gschmidt958/pdp11-05-reawakening/docs/PDP-11-05_Panel_Reawakening-Quick_Reference_Full_Page.pdf

# PDP-11/05 Panel Reawakening

## Quick Reference

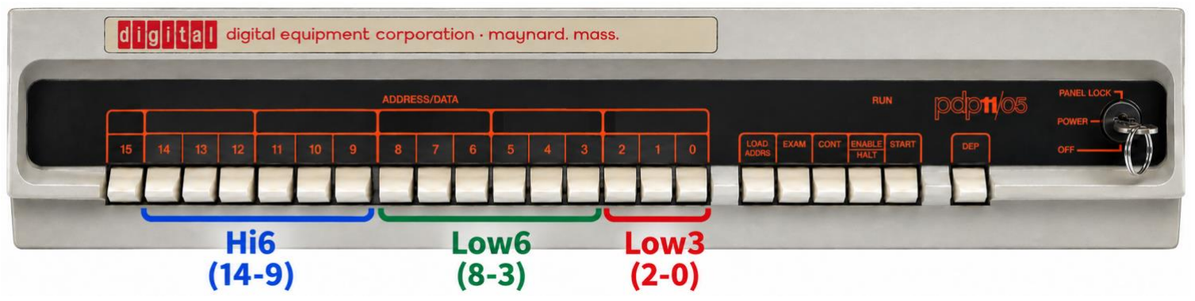
[picture p2: figure]

Toggle START to enter the mode set on Low3.

## Modes

Code | Mode | Hi6 | Low6 | Notes
0 (000) | Switch Echo | — | — | Echoes address/data switches directly on the LED display.
1 (001) | Binary Clock | — | — | CONTINUE cycles time → temperature → timer. Westminster chime on the quarter hour.
2 (010) | Blinkenlights Computer | Effect Selection | Track Selection | Audio and LED display effects run independently.
3 (011) | Soundboard | — | Theme Selection | Themed clips with voice-reactive VU meter (themes below).
4 (100) | Knight Rider | — | — | Fixed track with scanning-light display effect.
5 (101) | Jukebox | Track Selection | Folder Selection | SD card music player with music-style VU meter.
6 (110) | Bluetooth Audio | — | — | BT201 switches to Bluetooth source; volume from phone.
7 (111) | Flash Settings | — | — | CONTINUE cycles Address Select → Reset → VU Calibration.

## Soundboard Themes

Low6 | Theme
0 Random theme cycling (without replacement)
1 Robby the Robot (Forbidden Planet)
2 The B9 Environmental Robot (Lost in Space)
3 The HAL 9000 Computer (2001: A Space Odyssey) 4 Star Trek (original series)
5 Star Wars
6 Colossus (The Forbin Project)
7+ | Random track from random theme

LOAD ADDRS · EXAM · CONT · ENABLE/HALT · START · DEP — see the User Manual for full per-mode control behavior.

# PDP-11/05 Panel Reawakening

## Jukebox Channels

Mode 5 (101) · Low6 selects channel

Ch# | Channel Name | Ch# | Channel Name
1 | Electronic Ambient Covers | 15 | Computer World (Full Album)
2 | Ambient Electronic I | 16 | The Colours of Infinity
3 | Ambient Electronic II | 17 | Pink Floyd Style Ambient Music
4 | Synthwave | 18 | Voyage 34 (Full Album)
5 | Artemis Station | 19 | As Falls Wichita, So Falls Wichita Falls (Full Album)
6 | Cadwell’s Reach | 20 | I Dream of Star Trek
7 | Echelon Protocol | 21 | Forbidden Planet Electronic Tonalities
8 | Navigating a Latent Space | 22 | Do it Yourself
9 | Arrival at Myriah’s Shadow | 23 | Initial Call to the Military Fire Station from Chernobyl
10 | Night City | 24 | Jupiter II Engines
11 | Nova Sonus | 25 | Theme from “The Twilight Zone”
12 | To a Distant World | 26 | Theme from “The Outer Limits”
13 | Dune (Full Album) | 27 | Calibration Tone

14 Computer Love (Remaster)

Channels are selected with Low6; see the User Manual (Appendix I) for the tracks in each channel.
