gschmidt958/pdp11-05-reawakening/media/01.png

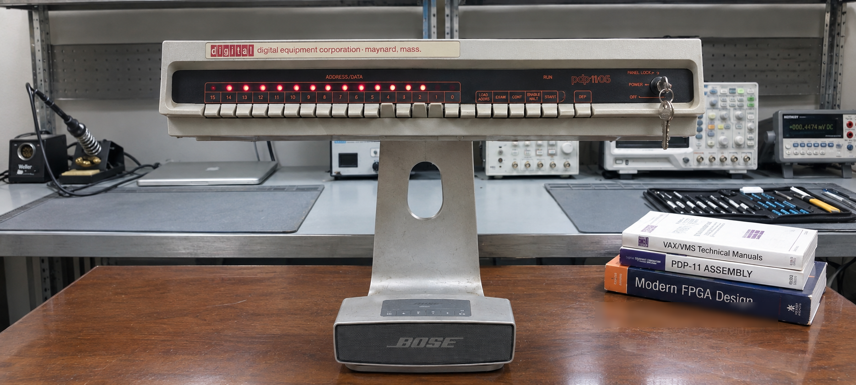
media/01.png
