gschmidt958/pdp11-05-reawakening/media/03.jpg

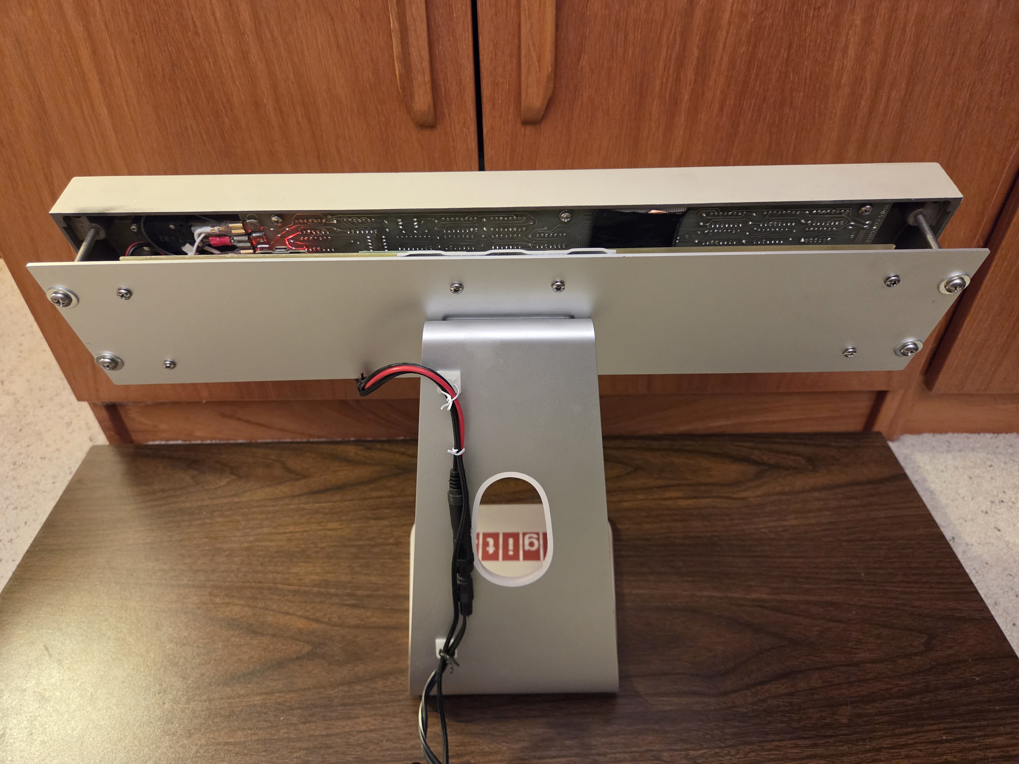
media/03.jpg
