gschmidt958/pdp11-05-reawakening/media/04.jpg

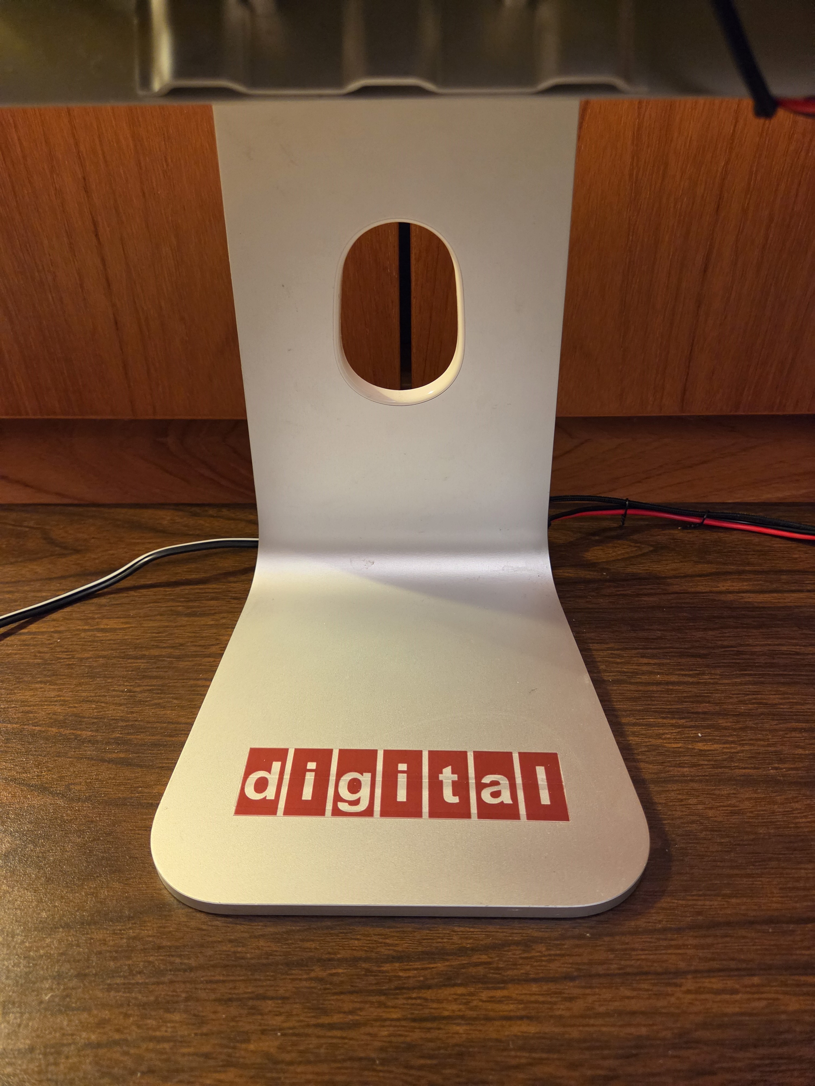
media/04.jpg
