gschmidt958/pdp11-05-reawakening/media/05.jpg

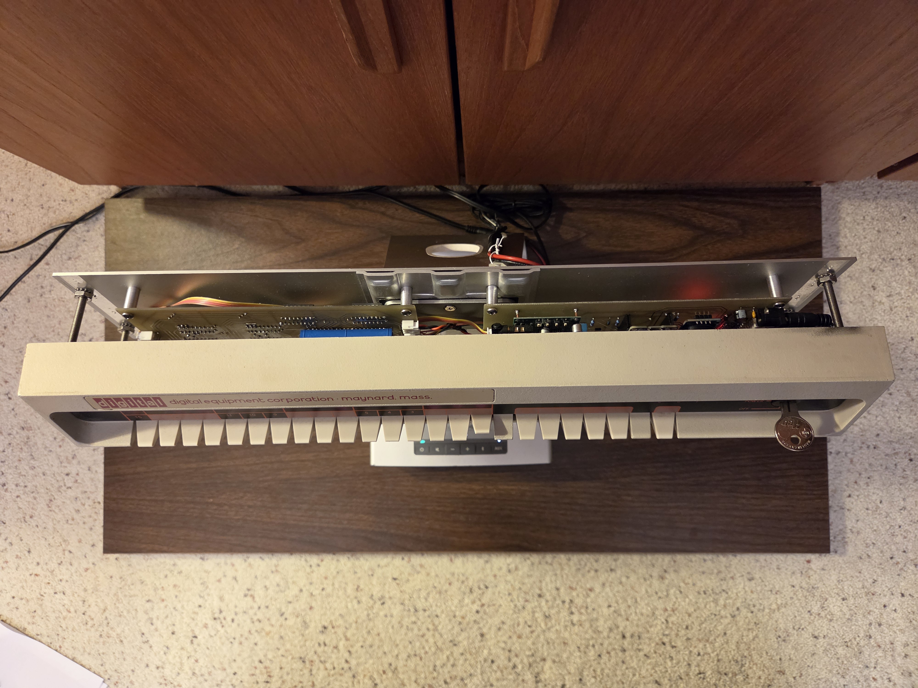
media/05.jpg
