gschmidt958/pdp11-05-reawakening/media/06.jpg

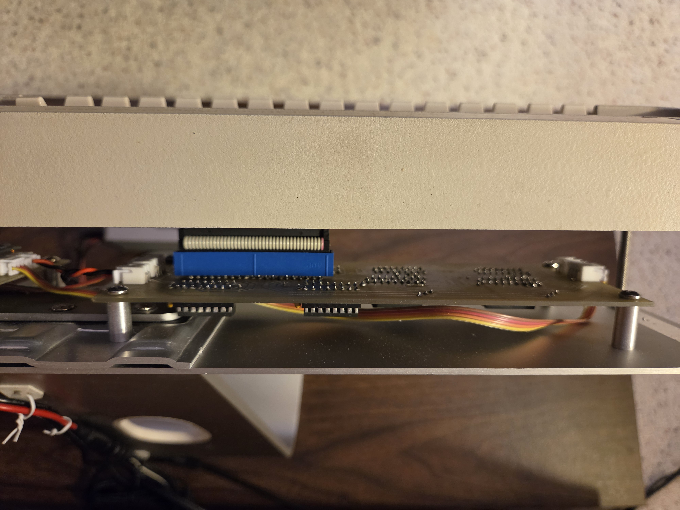
media/06.jpg
