gschmidt958/pdp11-05-reawakening/media/07.jpg

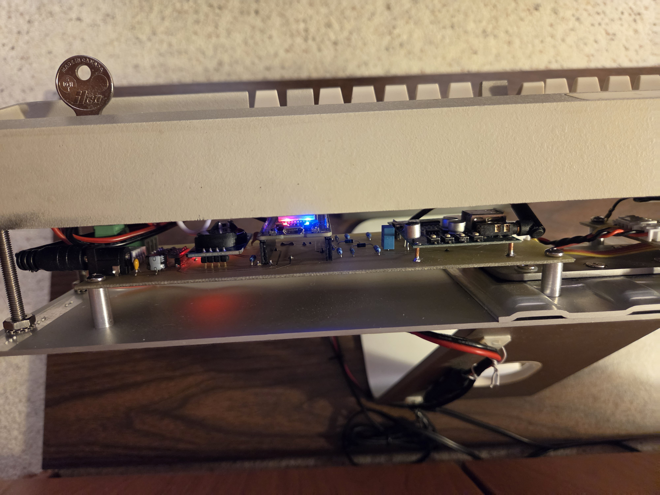
media/07.jpg
