gschmidt958/pdp11-05-reawakening/media/08.jpg

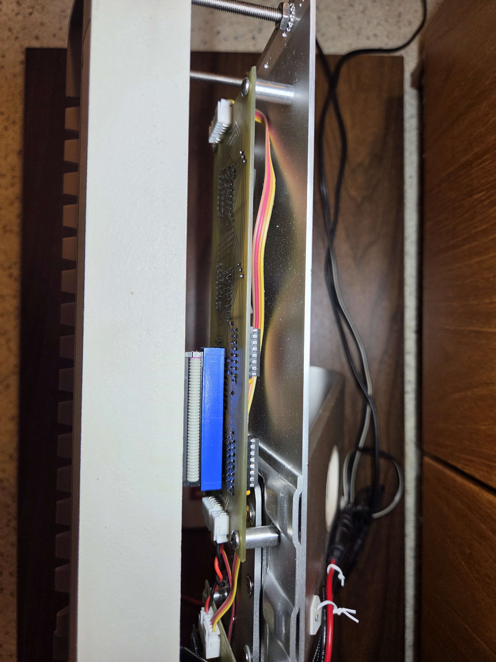
media/08.jpg
