gschmidt958/pdp11-05-reawakening/media/09.jpg

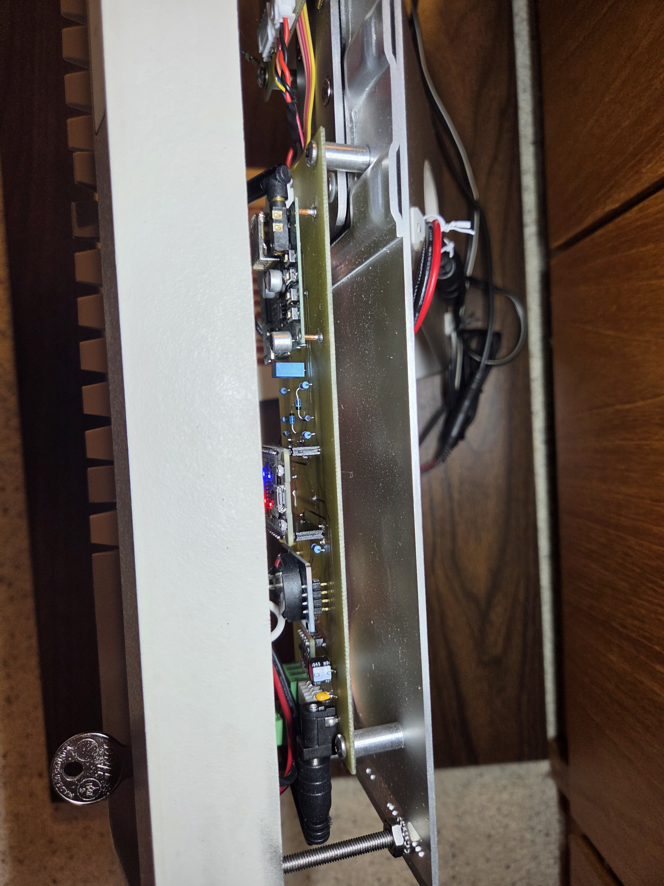
media/09.jpg
