gschmidt958/pdp11-05-reawakening/media/10.jpg

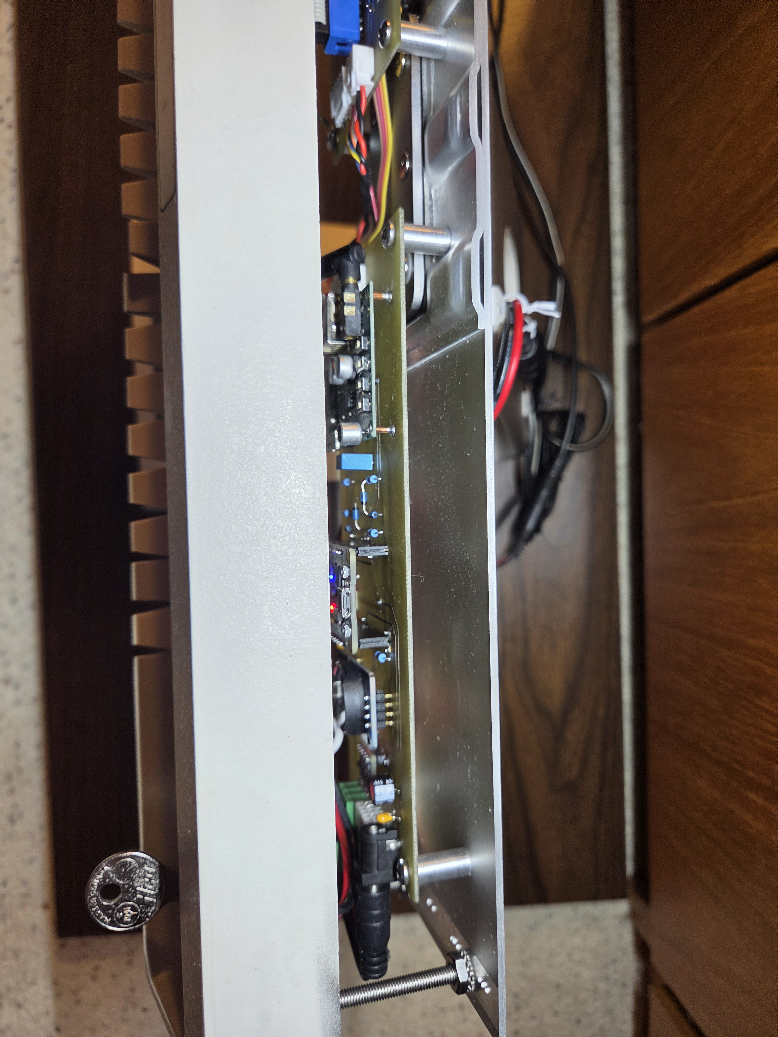
media/10.jpg
