gschmidt958/pdp11-05-reawakening/media/11.jpg

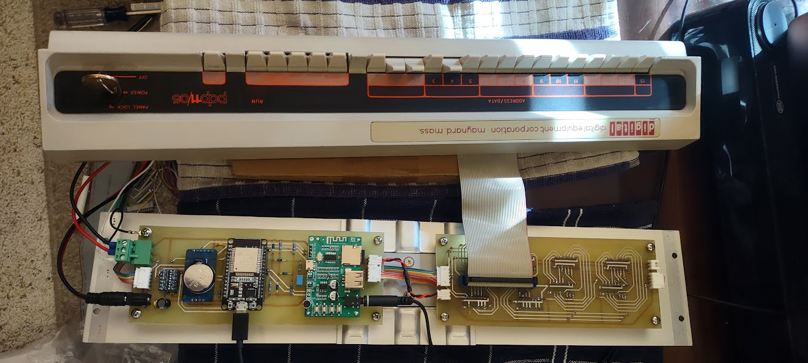
media/11.jpg
