gschmidt958/pdp11-05-reawakening/media/12.jpg

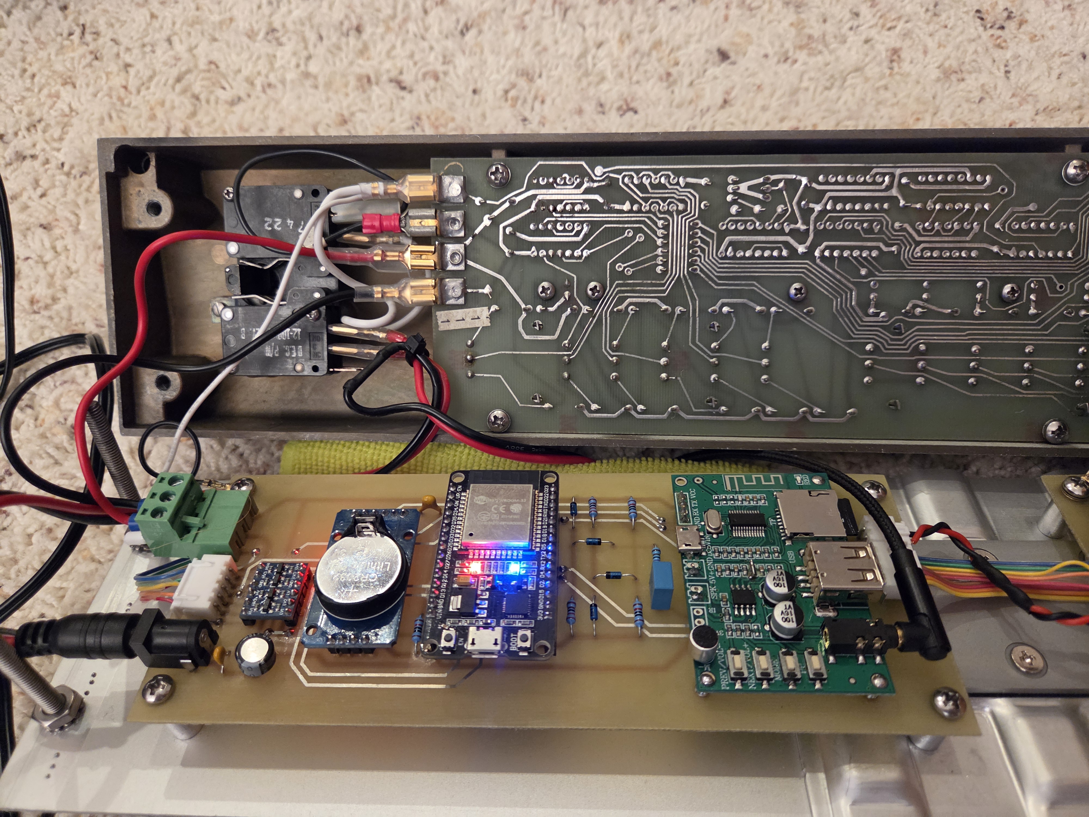
media/12.jpg
