gschmidt958/pdp11-05-reawakening/media/13.jpg

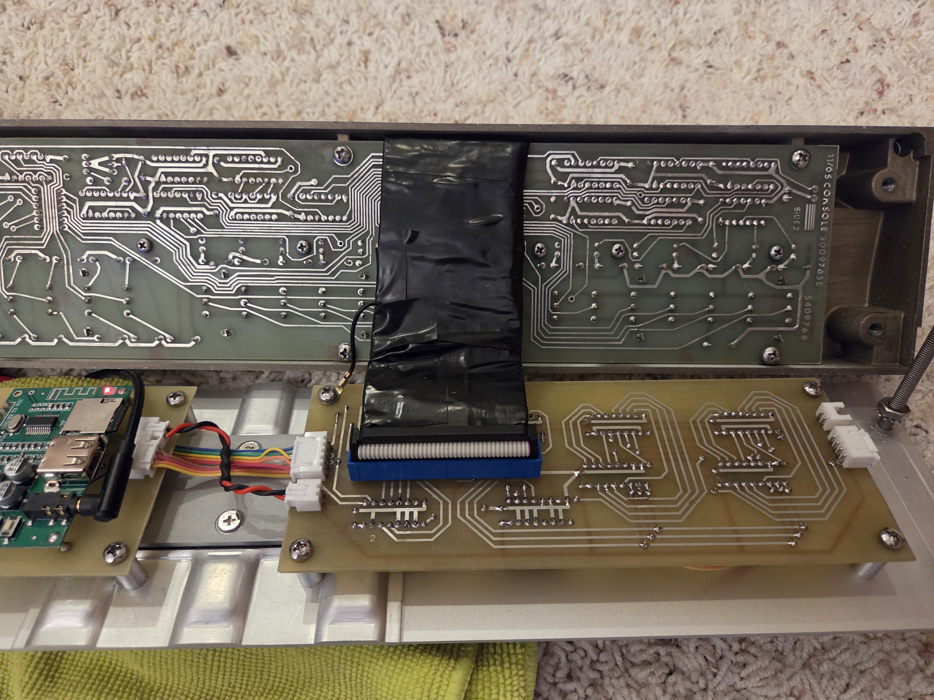
media/13.jpg
