gschmidt958/pdp11-05-reawakening/media/14.jpg

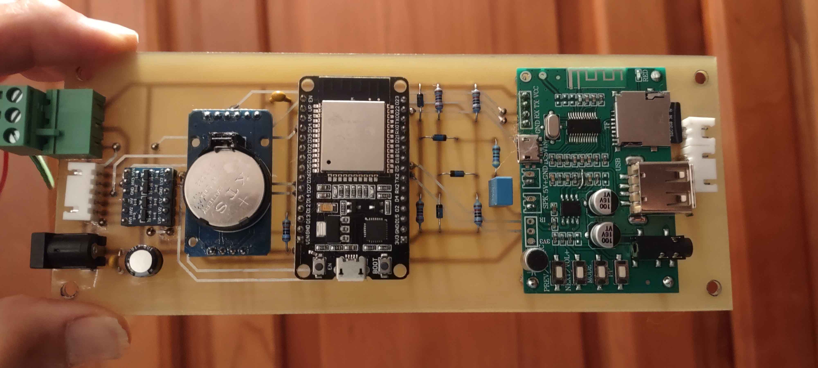
media/14.jpg
