gschmidt958/pdp11-05-reawakening/media/15.png

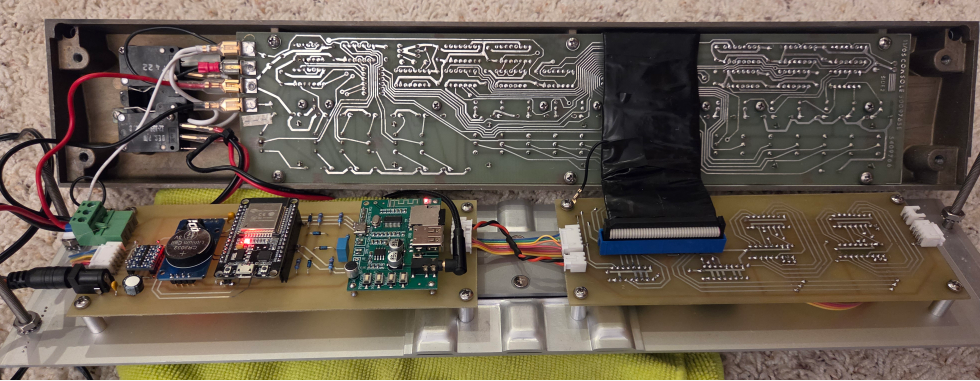
media/15.png
