gschmidt958/pdp11-05-reawakening/media/16.jpg

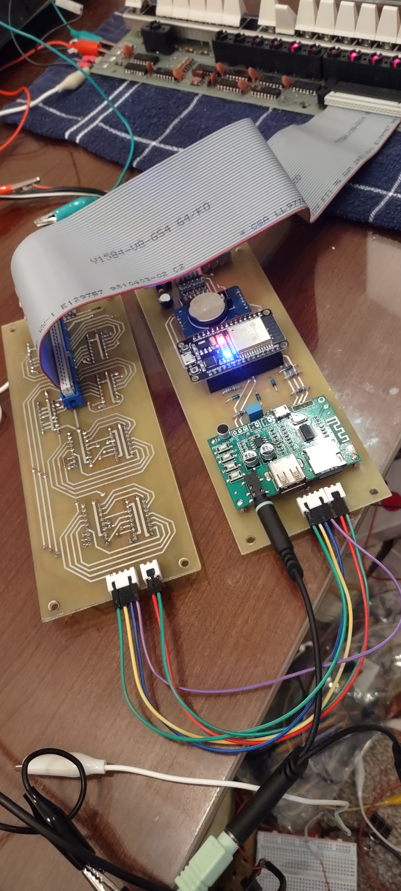
media/16.jpg
