gschmidt958/pdp11-05-reawakening/media/17.jpg

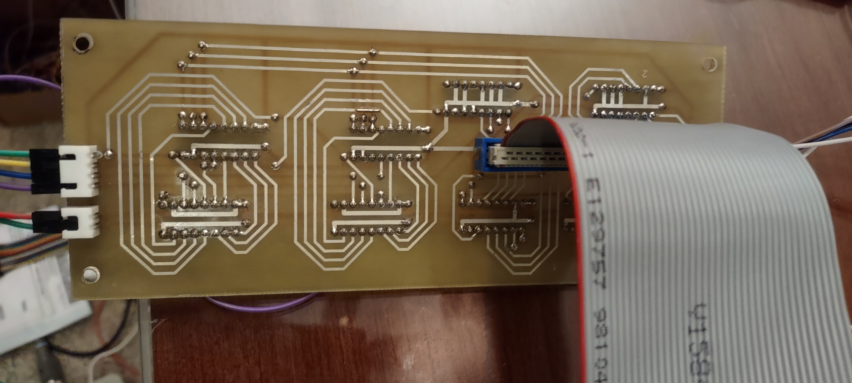
media/17.jpg
