gschmidt958/pdp11-05-reawakening/media/18.jpg

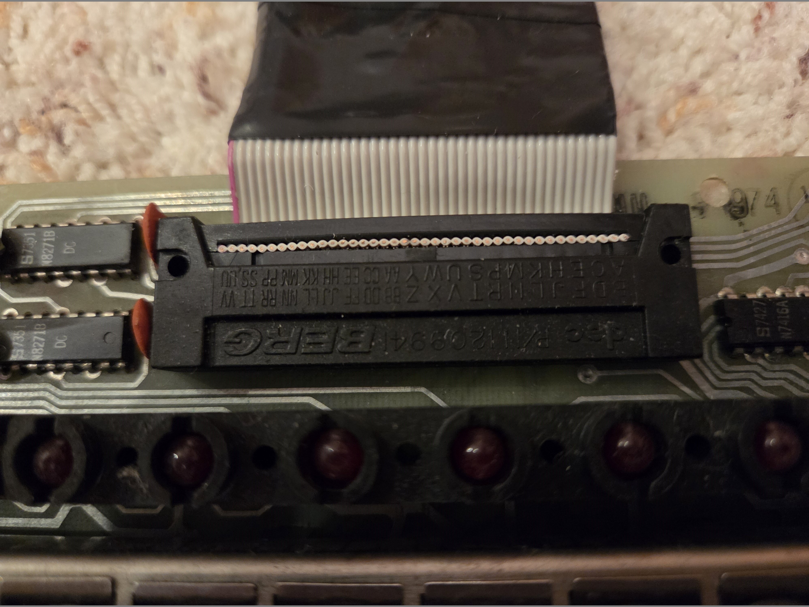
media/18.jpg
