gschmidt958/pdp11-05-reawakening/media/19.png

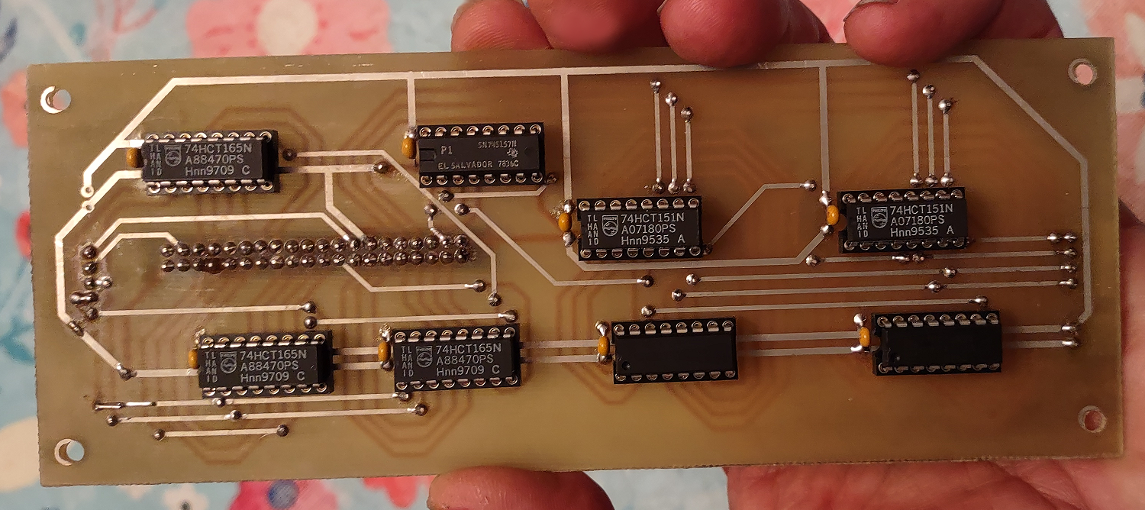
media/19.png
