gschmidt958/pdp11-05-reawakening/media/20.jpg

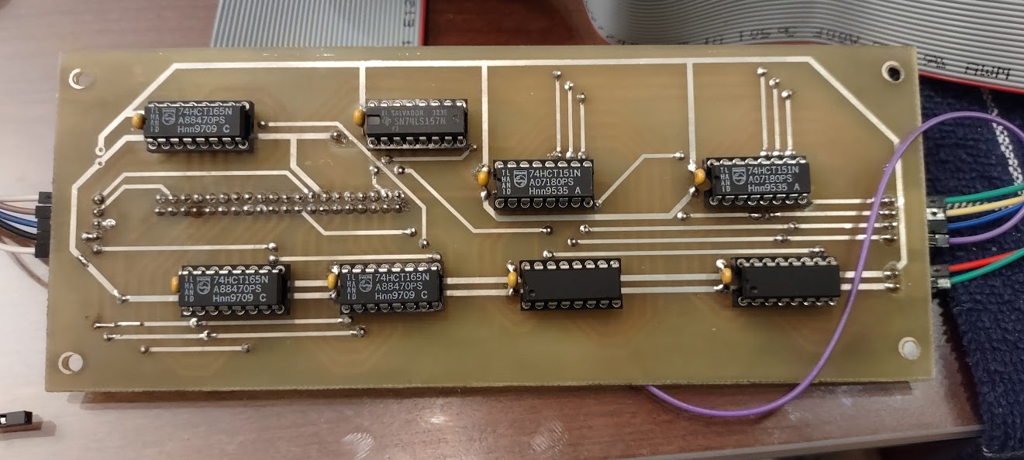
media/20.jpg
