gschmidt958/pdp11-05-reawakening/media/21.png

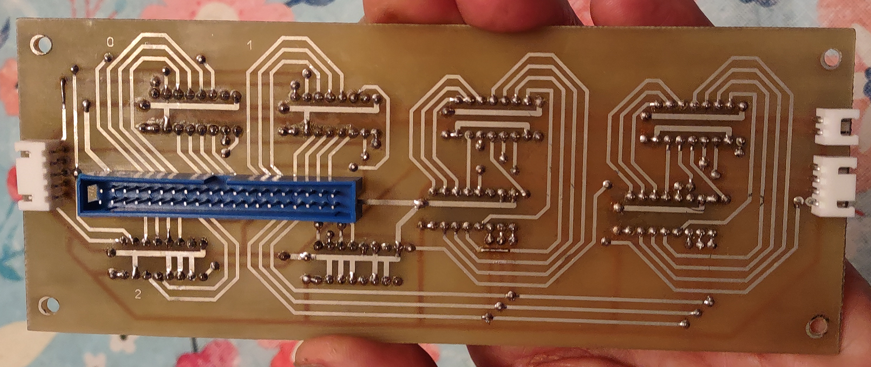
media/21.png
