gschmidt958/pdp11-05-reawakening/media/22.png

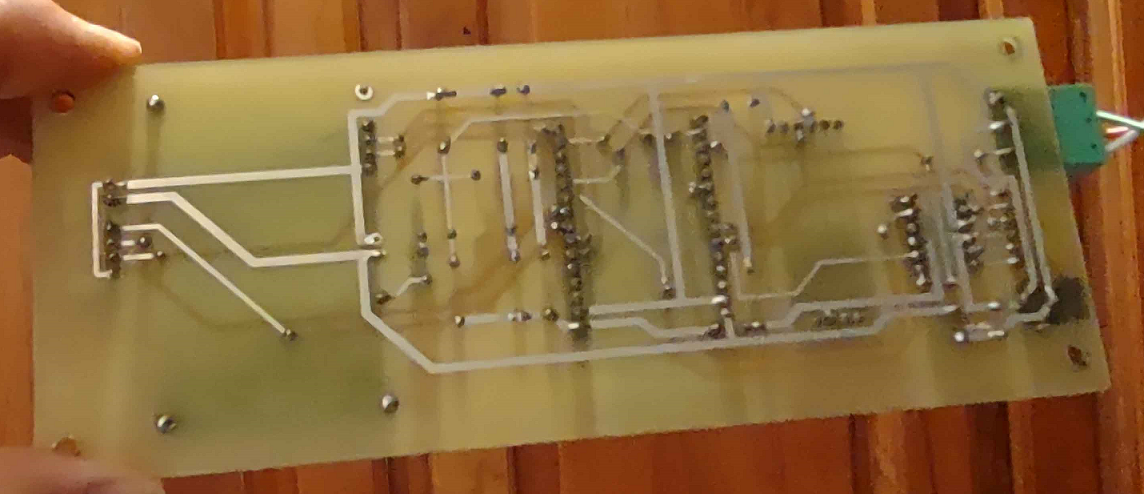
media/22.png
