gschmidt958/pdp11-05-reawakening/media/23.jpg

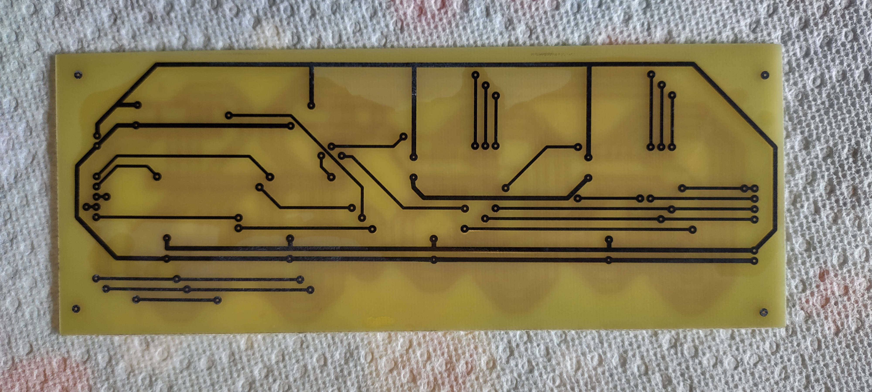
media/23.jpg
