gschmidt958/pdp11-05-reawakening/media/24.jpg

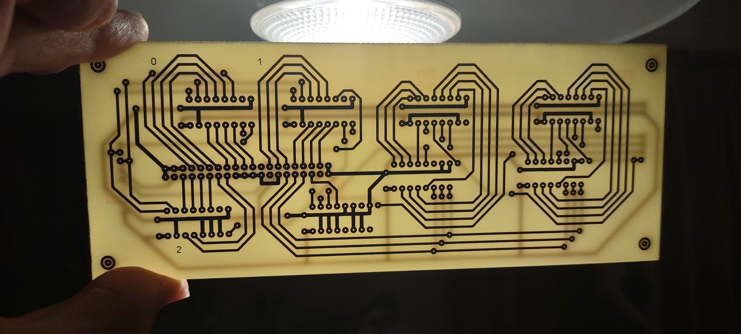
media/24.jpg
