gschmidt958/pdp11-05-reawakening/media/25.jpg

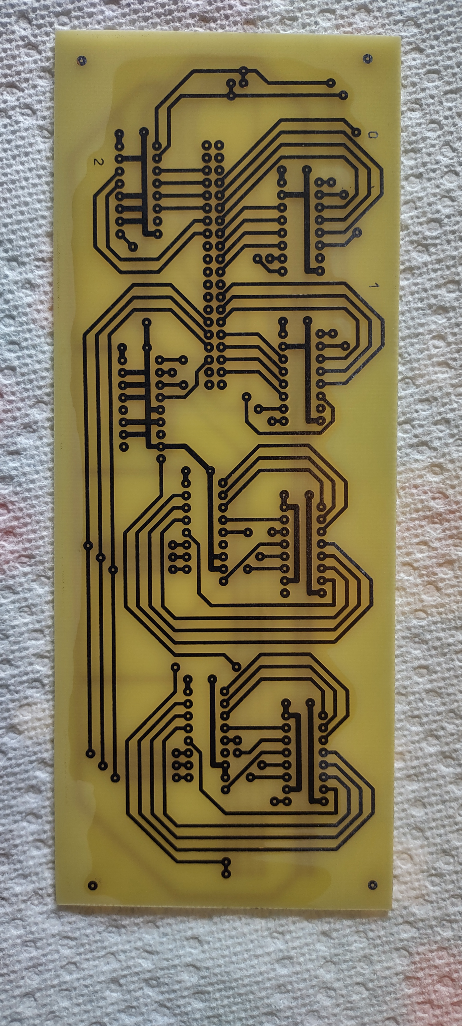
media/25.jpg
