gschmidt958/pdp11-05-reawakening/media/26.jpg

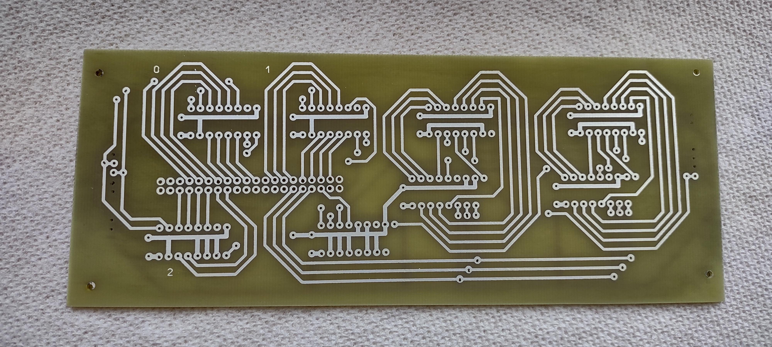
media/26.jpg
