gschmidt958/pdp11-05-reawakening/media/27.jpg

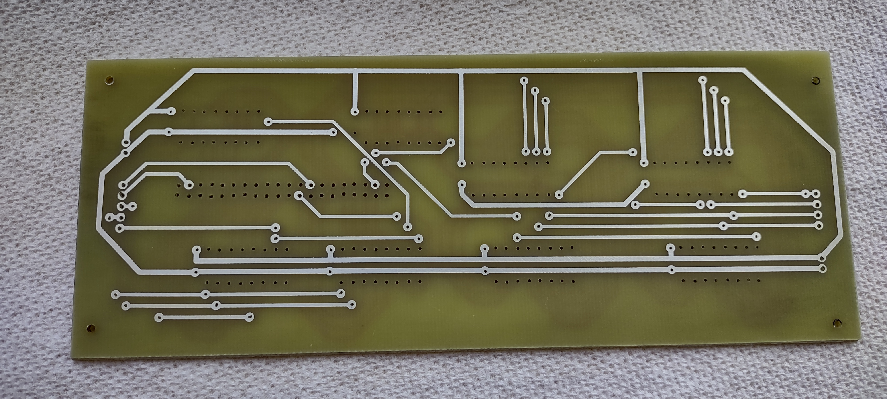
media/27.jpg
