gschmidt958/pdp11-05-reawakening/media/28.jpg

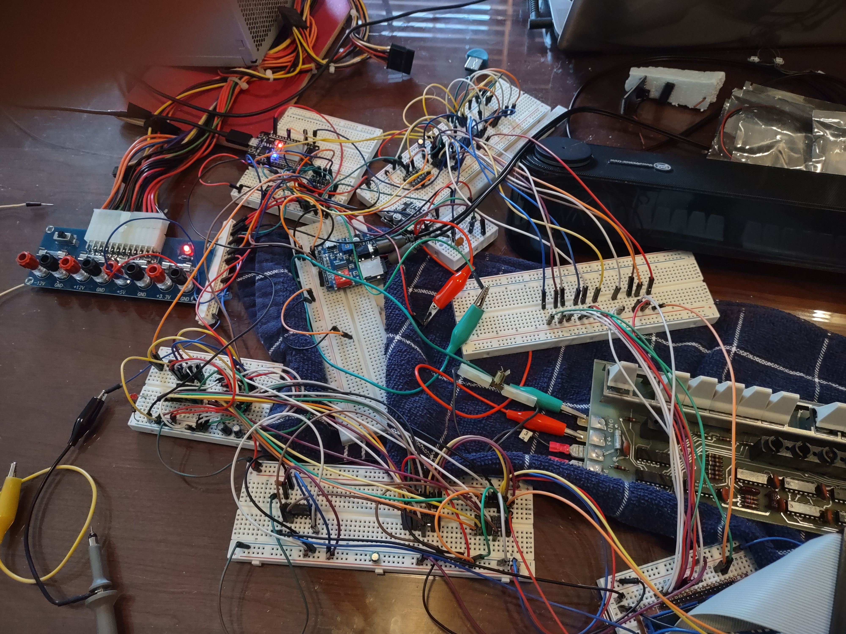
media/28.jpg
