gschmidt958/pdp11-05-reawakening/media/ControlPCB.png

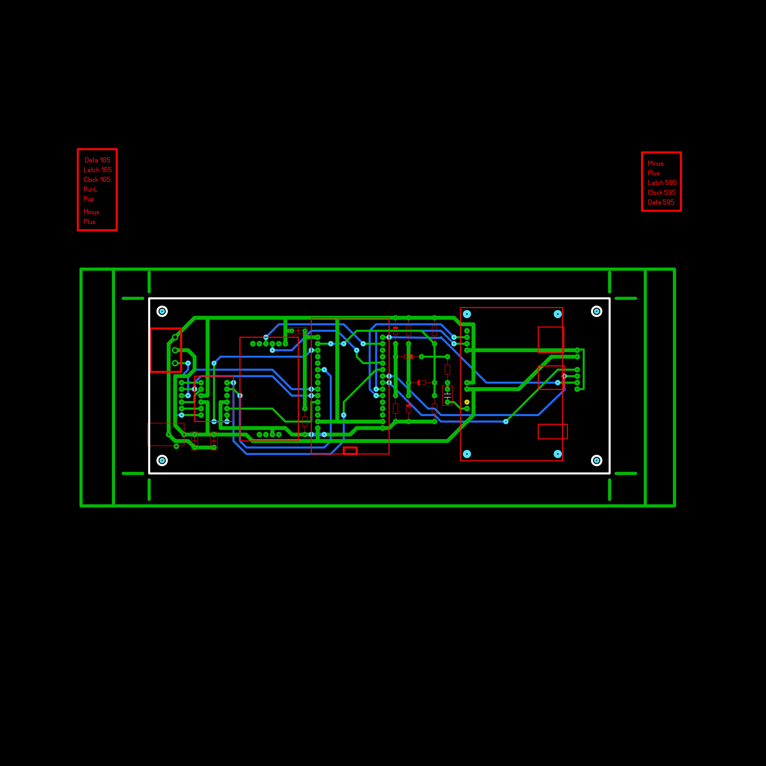
media/ControlPCB.png
