gschmidt958/pdp11-05-reawakening/media/InterfacePCB.png

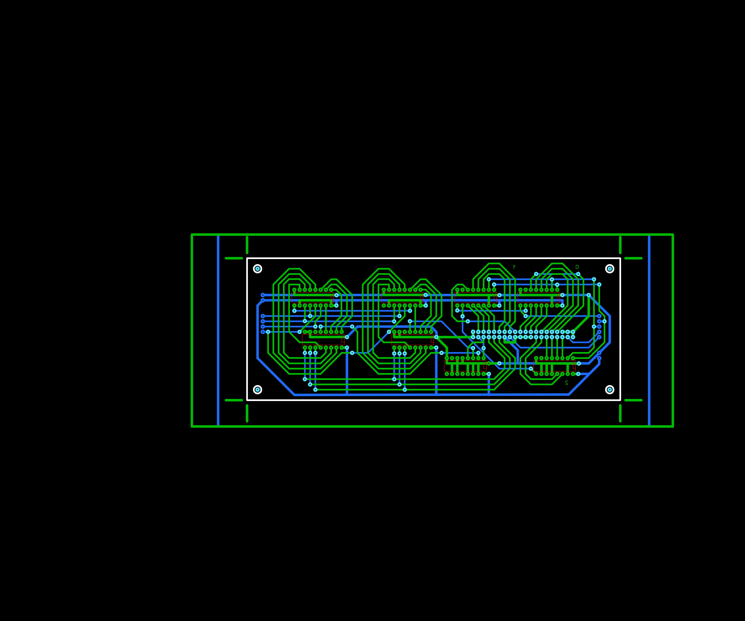
media/InterfacePCB.png
