gschmidt958/pdp11-05-reawakening/media/Sheet_1.png

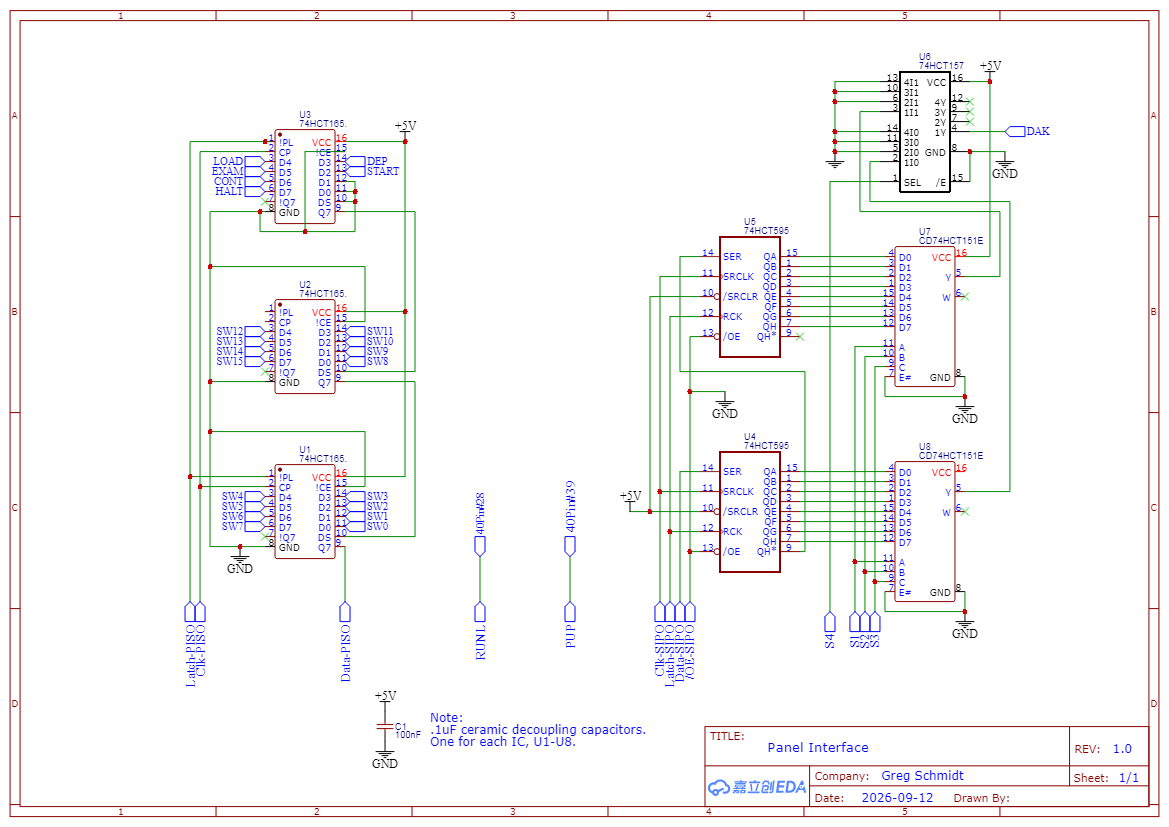
media/Sheet_1.png
