gschmidt958/pdp11-05-reawakening/media/Sheet_2.png

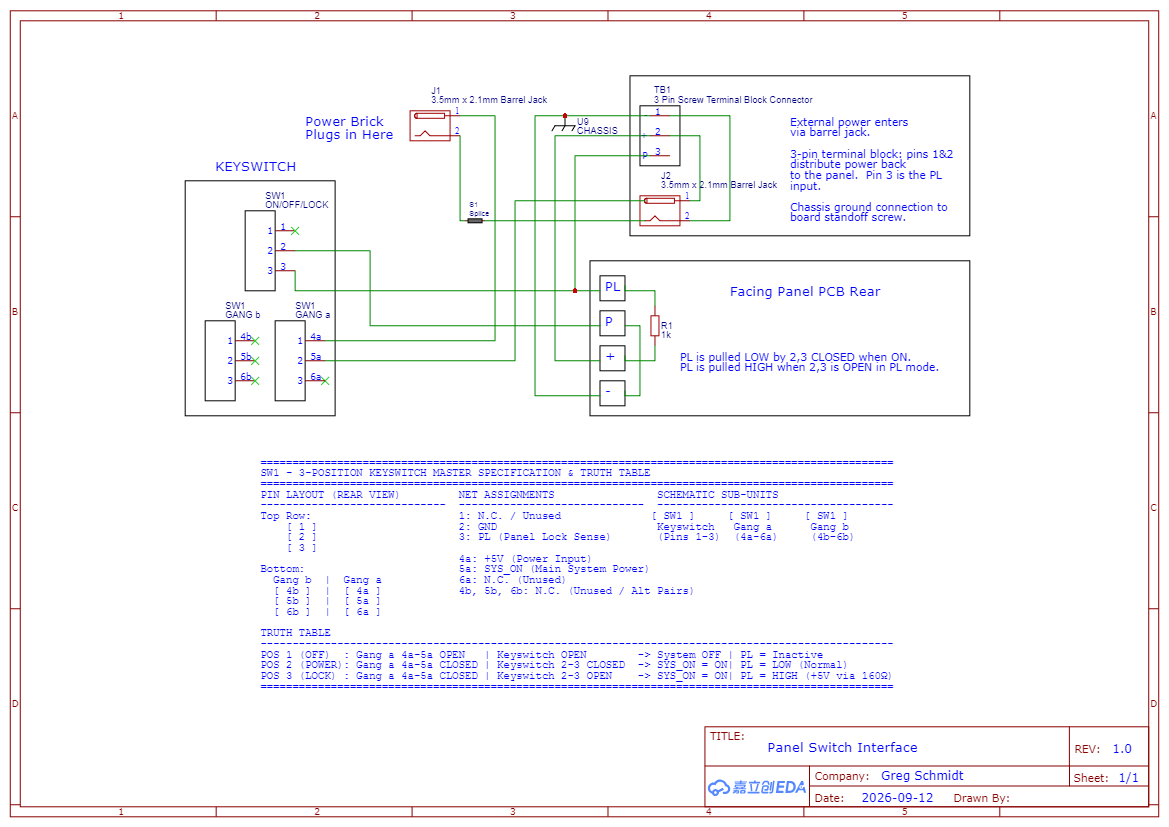
media/Sheet_2.png
