gschmidt958/pdp11-05-reawakening/media/Sheet_3.png

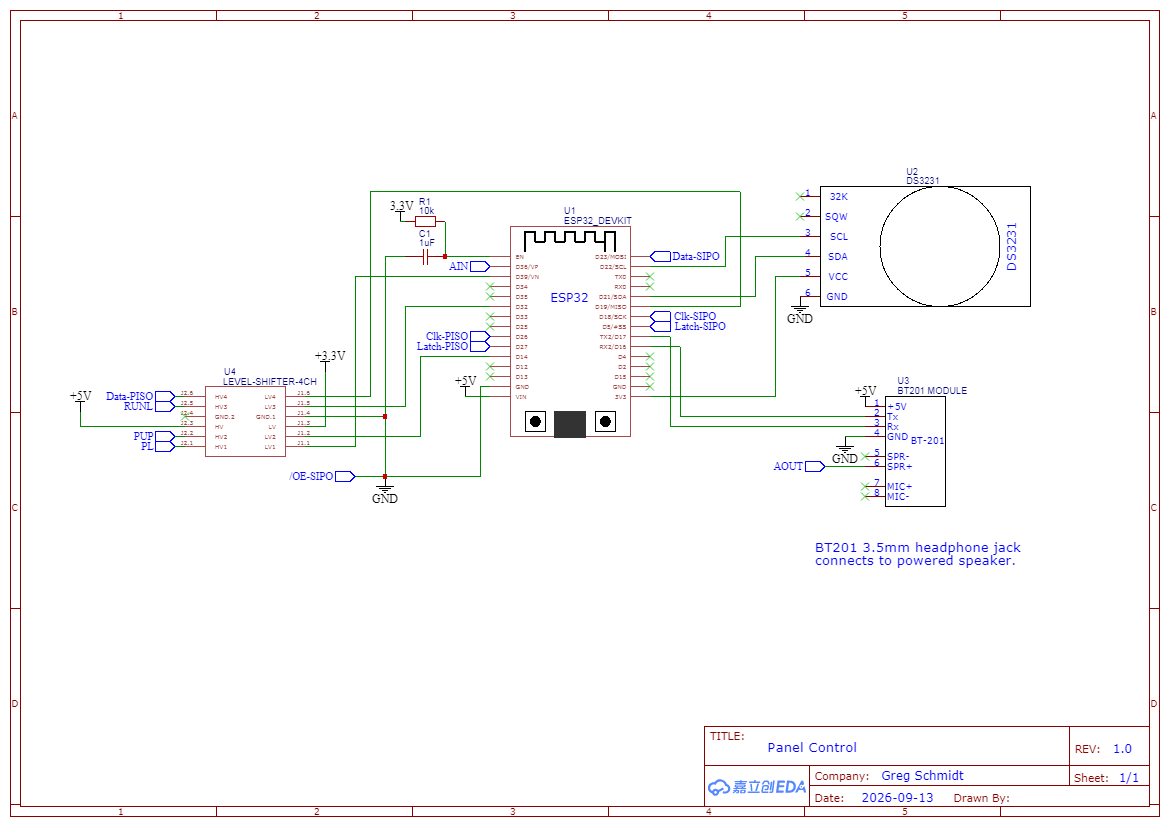
media/Sheet_3.png
