gschmidt958/pdp11-05-reawakening/media/Sheet_4.png

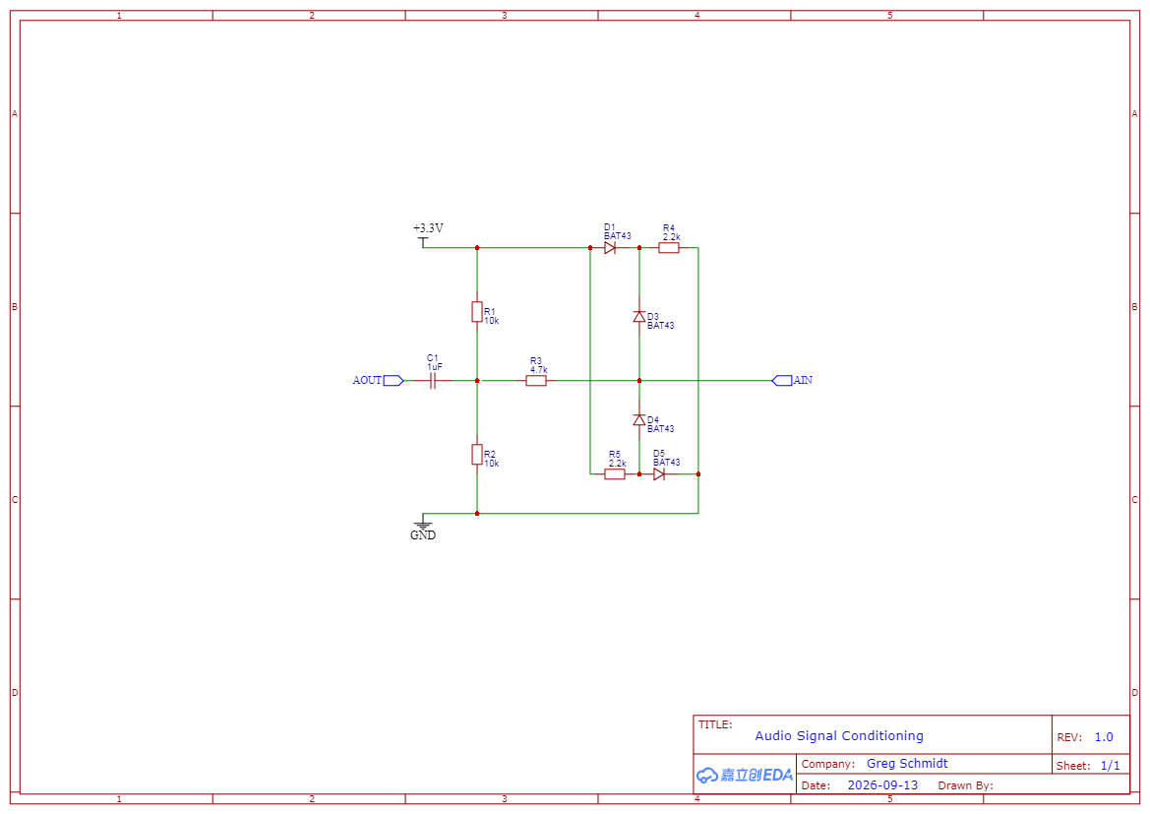
media/Sheet_4.png
