gschmidt958/pdp11-05-reawakening/(list of files, drawings)

Other design files:
layout/control_board/ControlBoardRot18.lay6
layout/interface_board/Layout2x_16.Etch12.lay6
