gschmidt958/pdp11-05-reawakening/src/SequencerPatternTasks.cpp

#include "SequencerPatternTasks.h"

uint16_t knightRiderPattern[] = {
  0b1000000000000000,
  0b1100000000000000,
  0b1110000000000000,
  0b0111000000000000,
  0b0011100000000000,
  0b0001110000000000,
  0b0000111000000000,
  0b0000011100000000,
  0b0000001110000000,
  0b0000000111000000,
  0b0000000011100000,
  0b0000000001110000,
  0b0000000000111000,
  0b0000000000011100,
  0b0000000000001110,
  0b0000000000000111,
  0b0000000000000011,
  0b0000000000000001,
  0b0000000000000011,
  0b0000000000000111,
  0b0000000000001110,
  0b0000000000011100,
  0b0000000000111000,
  0b0000000001110000,
  0b0000000011100000,
  0b0000000111000000,
  0b0000001110000000,
  0b0000011100000000,
  0b0000111000000000,
  0b0001110000000000,
  0b0011100000000000,
  0b0111000000000000,
  0b1110000000000000,
  0b1100000000000000
};

SequencerDisplayTask knightRiderDisplayTask("KnightRiderDisplay", 50, knightRiderPattern, sizeof(knightRiderPattern)/sizeof(uint16_t));

uint16_t crissCrossPattern[] = {
  0b1000000000000001,
  0b0100000000000010,
  0b0010000000000100,
  0b0001000000001000,
  0b0000100000010000,
  0b0000010000100000,
  0b0000001001000000,
  0b0000000110000000,
  0b0000001001000000,
  0b0000010000100000,
  0b0000100000010000,
  0b0001000000001000,
  0b0010000000000100,
  0b0100000000000010
};

SequencerDisplayTask crissCrossDisplayTask("CrissCrossDisplay", 100, crissCrossPattern, sizeof(crissCrossPattern)/sizeof(uint16_t));

uint16_t checkerboardPattern[] = {
  0b1010101010101010,
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
  0b0001001001001001,
  0b0010010010010010,
  0b0011011011011011,
  0b0100100100100100,
  0b0101101101101101,
  0b0110110110110110,
  0b0111111111111111,
};

SequencerDisplayTask octalFillDisplayTask("OctalFillDisplay", 450, octalFillPattern, sizeof(octalFillPattern)/sizeof(uint16_t));
