gschmidt958/pdp11-05-reawakening/(commit log)

2026-10-22 Add files via upload
    Add /layout
    [ControlBoardRot18.lay6, Layout2x_16.Etch12.lay6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]
2026-10-23 Add docs, layout, and media
    [ControlBoardRot18.lay6, Layout2x_16.Etch12.lay6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]
